jasmehar/Smart_motorcycle_helmet/KiCAD files (PCB design)/Round 2/Motorcycle_Round3_PreMUX/Motorcycle/Motorcycle/Motorcycle/smart_helmet/smart_helmet.kicad_pcb

## KiCad design KiCAD files (PCB design)/Round 2/Motorcycle_Round3_PreMUX/Motorcycle/Motorcycle/Motorcycle/smart_helmet/smart_helmet.kicad_pcb (2024-03-28)

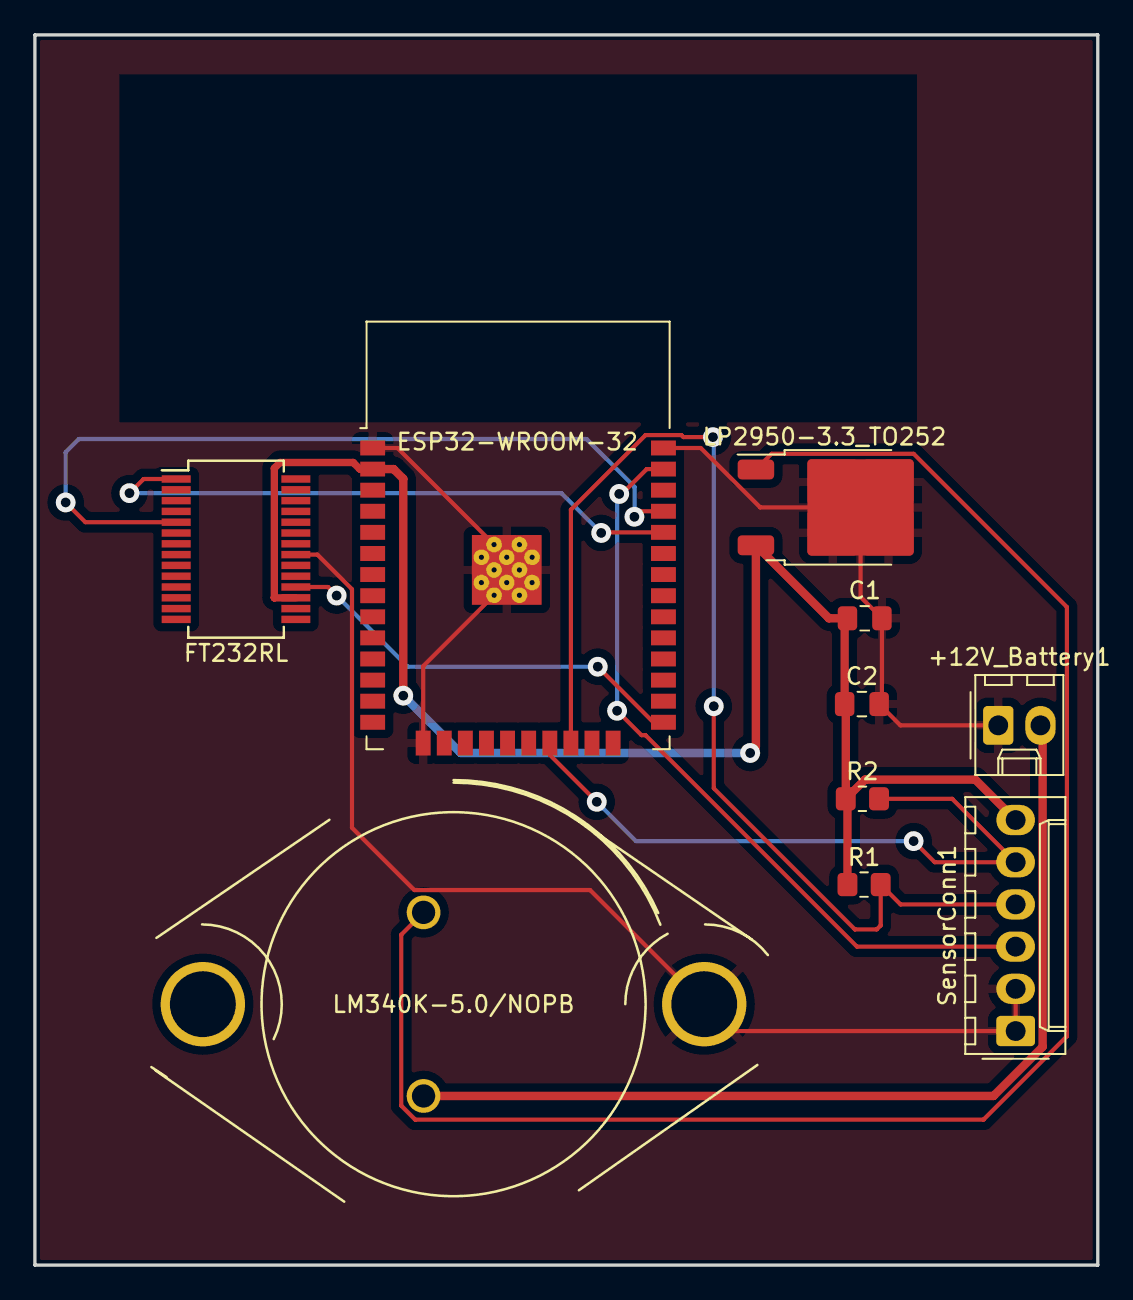
[picture p35: board KiCAD files (PCB design)/Round 2/Motorcycle_Round3_PreMUX/Motorcycle/… from above]

Board: 2 copper layers, 64.0 x 74.0 mm, 10 parts (0 on the bottom side), 10 nets.

Parts:
+12V_Battery1: Conn_01x02; Molex_KK-254_AE-6410-02A_1x02_P2.54mm_Vertical
C1, C2: 0.0000001; C_0805_2012Metric_Pad1.18x1.45mm_HandSolder
R1, R2: 10000; R_0805_2012Metric_Pad1.20x1.40mm_HandSolder
SensorConn1: Conn_01x06; Molex_KK-254_AE-6410-06A_1x06_P2.54mm_Vertical
U1: FT232RL; SSOP-28_5.3x10.2mm_P0.65mm
U3: LM340K-5.0/NOPB; LM340K-5.0&slash_NOPB
U4: LP2950-3.3_TO252; TO-252-2
U5: ESP32-WROOM-32

Connections:
/INT: SensorConn1.3, U5.37 (IO23)
/SCL: R1.2, SensorConn1.4, U5.22 (SDI/SD1)
/SDA: R2.2, SensorConn1.5, U5.21 (SDO/SD0)
/VDD: C1.1, C2.1, R1.1, R2.1, SensorConn1.6, U1.17 (3V3OUT), U4.3 (VO), U5.2 (VDD)
GND: +12V_Battery1.1, C1.2, C2.2, SensorConn1.1, SensorConn1.2, U1.21 (GND), U3.3 (GND), U4.2 (GND), U5.1 (GND), U5.15 (GND), U5.38 (GND), U5.39 (GND)
unnamed: +12V_Battery1.2, U3.1 (IN)
unnamed: U1.5 (RXD), U5.35 (TXD0/IO1)
unnamed: U1.1 (TXD), U5.34 (RXD0/IO3)
unnamed: U3.2 (OUT), U4.1 (VI)
unnamed: U1.18 (GND), U5.25 (IO0)
