jasmehar/Smart_motorcycle_helmet/KiCAD files (PCB design)/Round 2/Helmet_Round3_PreMUX/Helmet/Helmet/Helmet/shematic for power and light system.kicad_pcb

## KiCad design KiCAD files (PCB design)/Round 2/Helmet_Round3_PreMUX/Helmet/Helmet/Helmet/shematic for power and light system.kicad_pcb (2024-03-28)

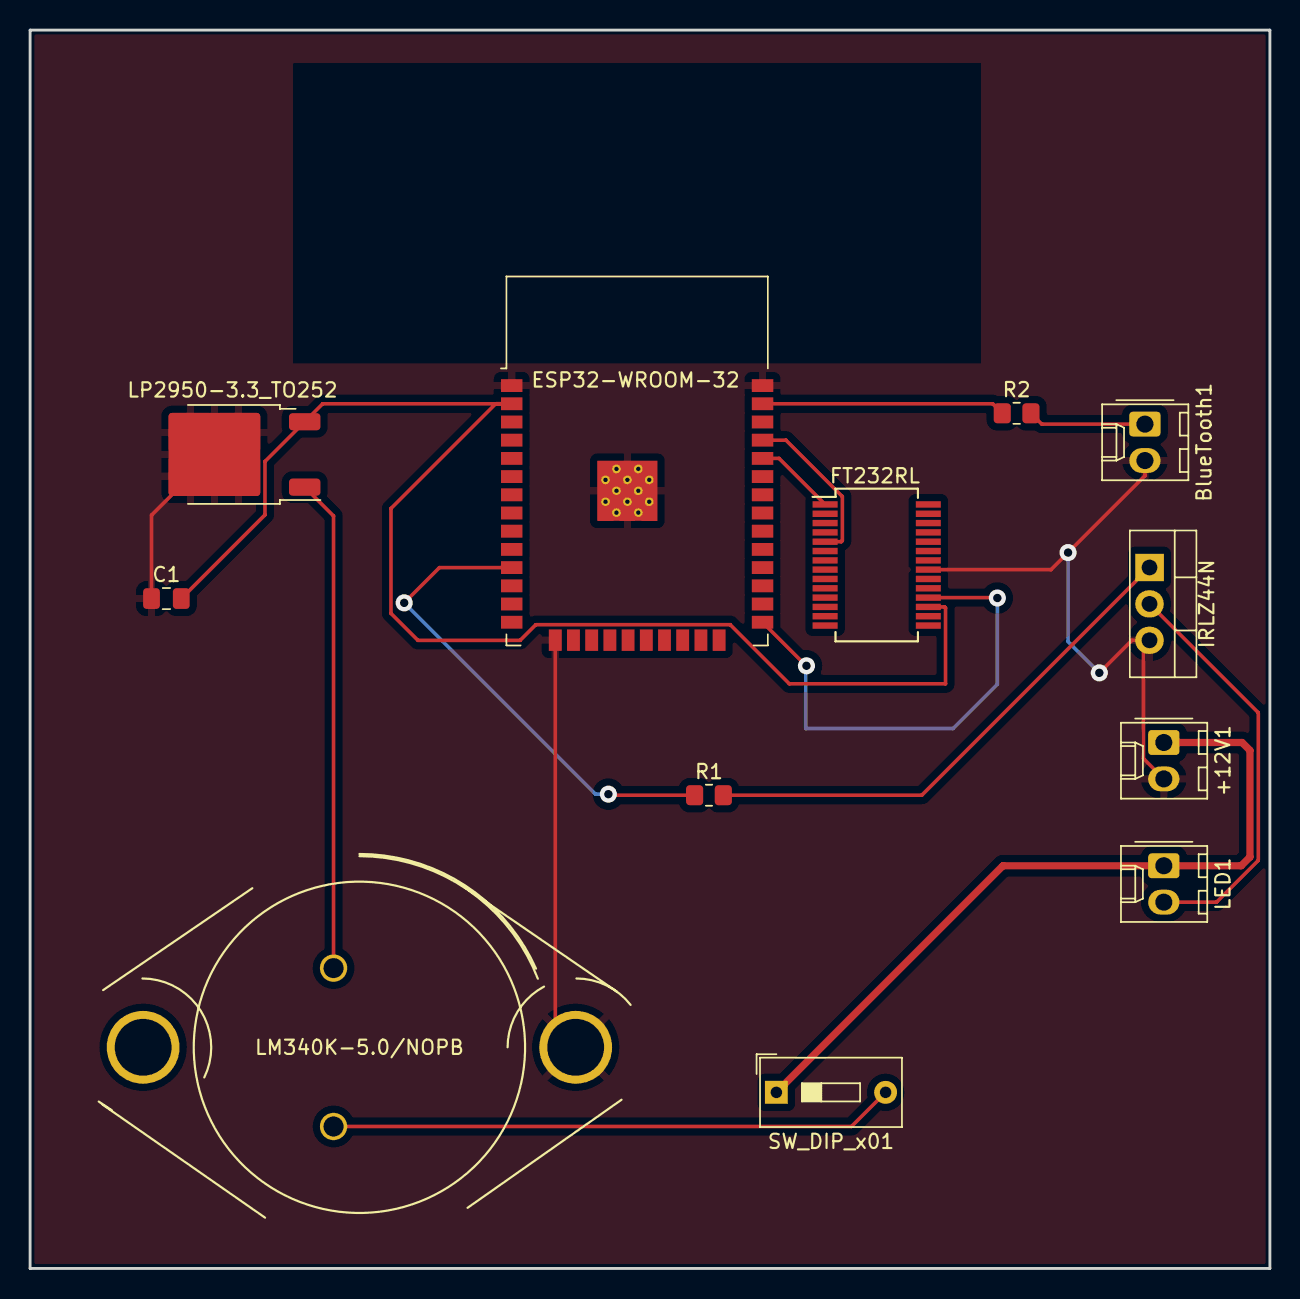
[picture p36: board KiCAD files (PCB design)/Round 2/Helmet_Round3_PreMUX/Helmet/Helmet/H… from above]

Board: 2 copper layers, 86.5 x 86.4 mm, 12 parts (0 on the bottom side), 13 nets.

Parts:
+12V1: Conn_01x02; Molex_KK-254_AE-6410-02A_1x02_P2.54mm_Vertical
BlueTooth1: LED; Molex_KK-254_AE-6410-02A_1x02_P2.54mm_Vertical
C1: 0.0000001; C_0805_2012Metric_Pad1.18x1.45mm_HandSolder
LED1: Conn_01x02; Molex_KK-254_AE-6410-02A_1x02_P2.54mm_Vertical
Q1: IRLZ44N; TO-220-3_Vertical
R1, R2: 10000; R_0805_2012Metric_Pad1.20x1.40mm_HandSolder
SW1: SW_DIP_x01; SW_DIP_SPSTx01_Slide_9.78x4.72mm_W7.62mm_P2.54mm
U1: LM340K-5.0/NOPB; LM340K-5.0&slash_NOPB
U2: LP2950-3.3_TO252; TO-252-2
U3: ESP32-WROOM-32
U4: FT232RL; SSOP-28_5.3x10.2mm_P0.65mm

Connections:
GND: +12V1.2, BlueTooth1.2, C1.1, Q1.3 (S), U1.3 (GND), U2.2 (GND), U3.1 (GND), U3.15 (GND), U3.38 (GND), U3.39 (GND), U4.21 (GND)
unnamed: +12V1.1, LED1.1, SW1.1
unnamed: BlueTooth1.1, R2.2
unnamed: LED1.2, Q1.2 (D)
unnamed: Q1.1 (G), R1.2
unnamed: SW1.2, U1.1 (IN)
unnamed: U1.2 (OUT), U2.1 (VI)
unnamed: C1.2, U2.3 (VO), U3.2 (VDD), U4.17 (3V3OUT)
unnamed: U3.25 (IO0), U4.18 (GND)
unnamed: R2.1, U3.37 (IO23)
unnamed: R1.1, U3.11 (IO26)
unnamed: U3.34 (RXD0/IO3), U4.1 (TXD)
unnamed: U3.35 (TXD0/IO1), U4.5 (RXD)
