jasmehar/Smart_motorcycle_helmet/KiCAD files (PCB design)/Round 1/Motorcycle/smart_helmet/smart_helmet.kicad_pcb

## KiCad design KiCAD files (PCB design)/Round 1/Motorcycle/smart_helmet/smart_helmet.kicad_pcb (2024-03-01)

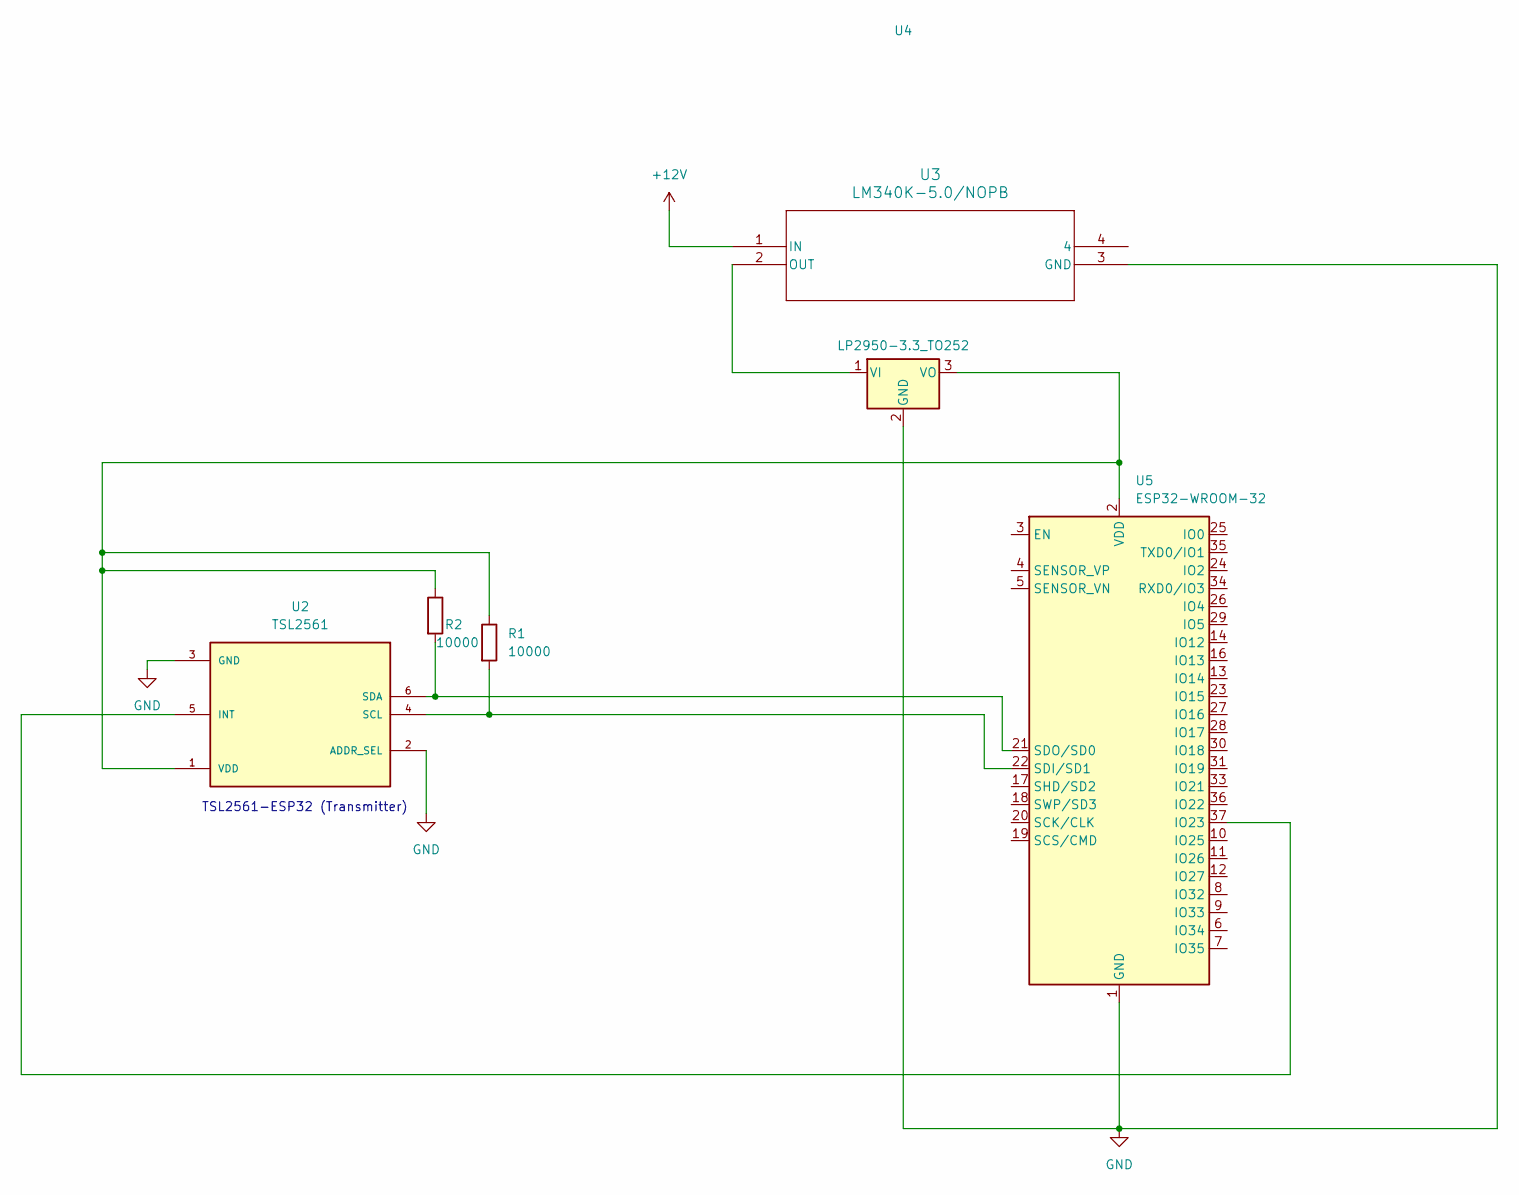
[picture p37: schematic smart_helmet.kicad_sch]

Parts:
R1, R2: 10000; R_0805_2012Metric_Pad1.20x1.40mm_HandSolder
U2: TSL2561; XDCR_TSL2561; PARTREV v1-01
U3: LM340K-5.0/NOPB; LM340K-5.0&slash_NOPB
U4: LP2950-3.3_TO252; TO-252-2
U5: ESP32-WROOM-32

Connections:
+12V: U3.1 (IN)
GND: U2.2 (ADDR_SEL), U2.3 (GND), U3.3 (GND), U4.2 (GND), U5.1 (GND), U5.15 (GND), U5.38 (GND), U5.39 (GND)
unnamed: U2.5 (INT), U5.37 (IO23)
unnamed: R1.2, U2.4 (SCL), U5.22 (SDI/SD1)
unnamed: R2.2, U2.6 (SDA), U5.21 (SDO/SD0)
unnamed: R1.1, R2.1, U2.1 (VDD), U4.3 (VO), U5.2 (VDD)
unnamed: U3.2 (OUT), U4.1 (VI)

Notes on the sheet:
TSL2561-ESP32 (Transmitter)

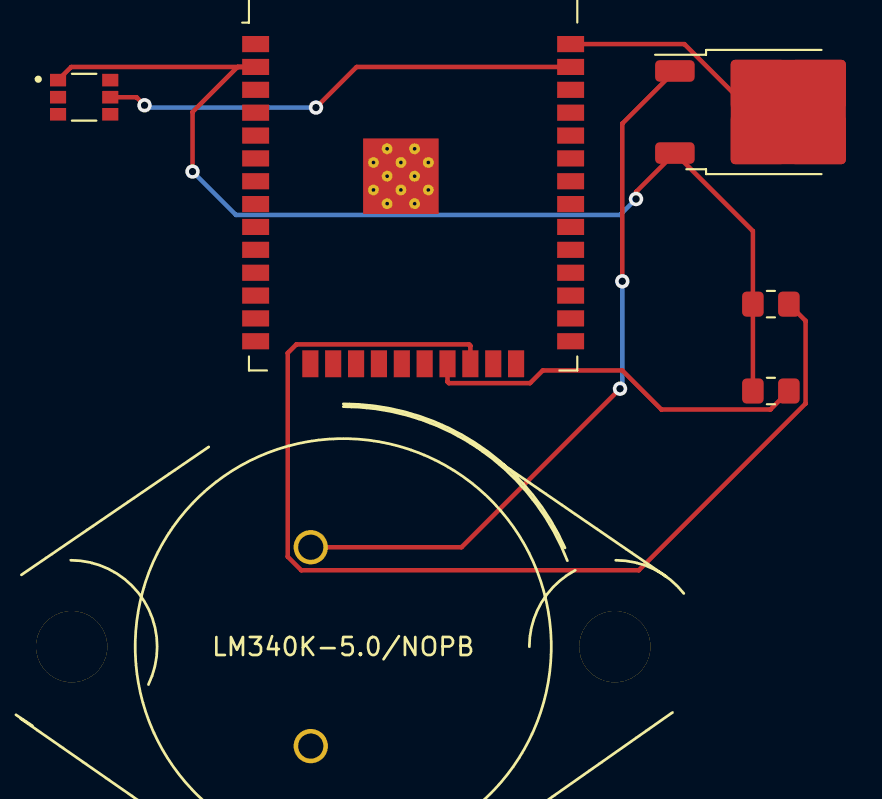
[picture p38: board KiCAD files (PCB design)/Round 1/Motorcycle/smart_helmet/smart_helmet… from above]

Board: 2 copper layers, 6 parts (0 on the bottom side), 6 nets.
