jasmehar/Smart_motorcycle_helmet/KiCAD files (PCB design)/Round 3/Motorcycle_Round3/Motorcycle/Motorcycle/Motorcycle/smart_helmet/smart_helmet.kicad_pcb

## KiCad design KiCAD files (PCB design)/Round 3/Motorcycle_Round3/Motorcycle/Motorcycle/Motorcycle/smart_helmet/smart_helmet.kicad_pcb (2024-03-28)

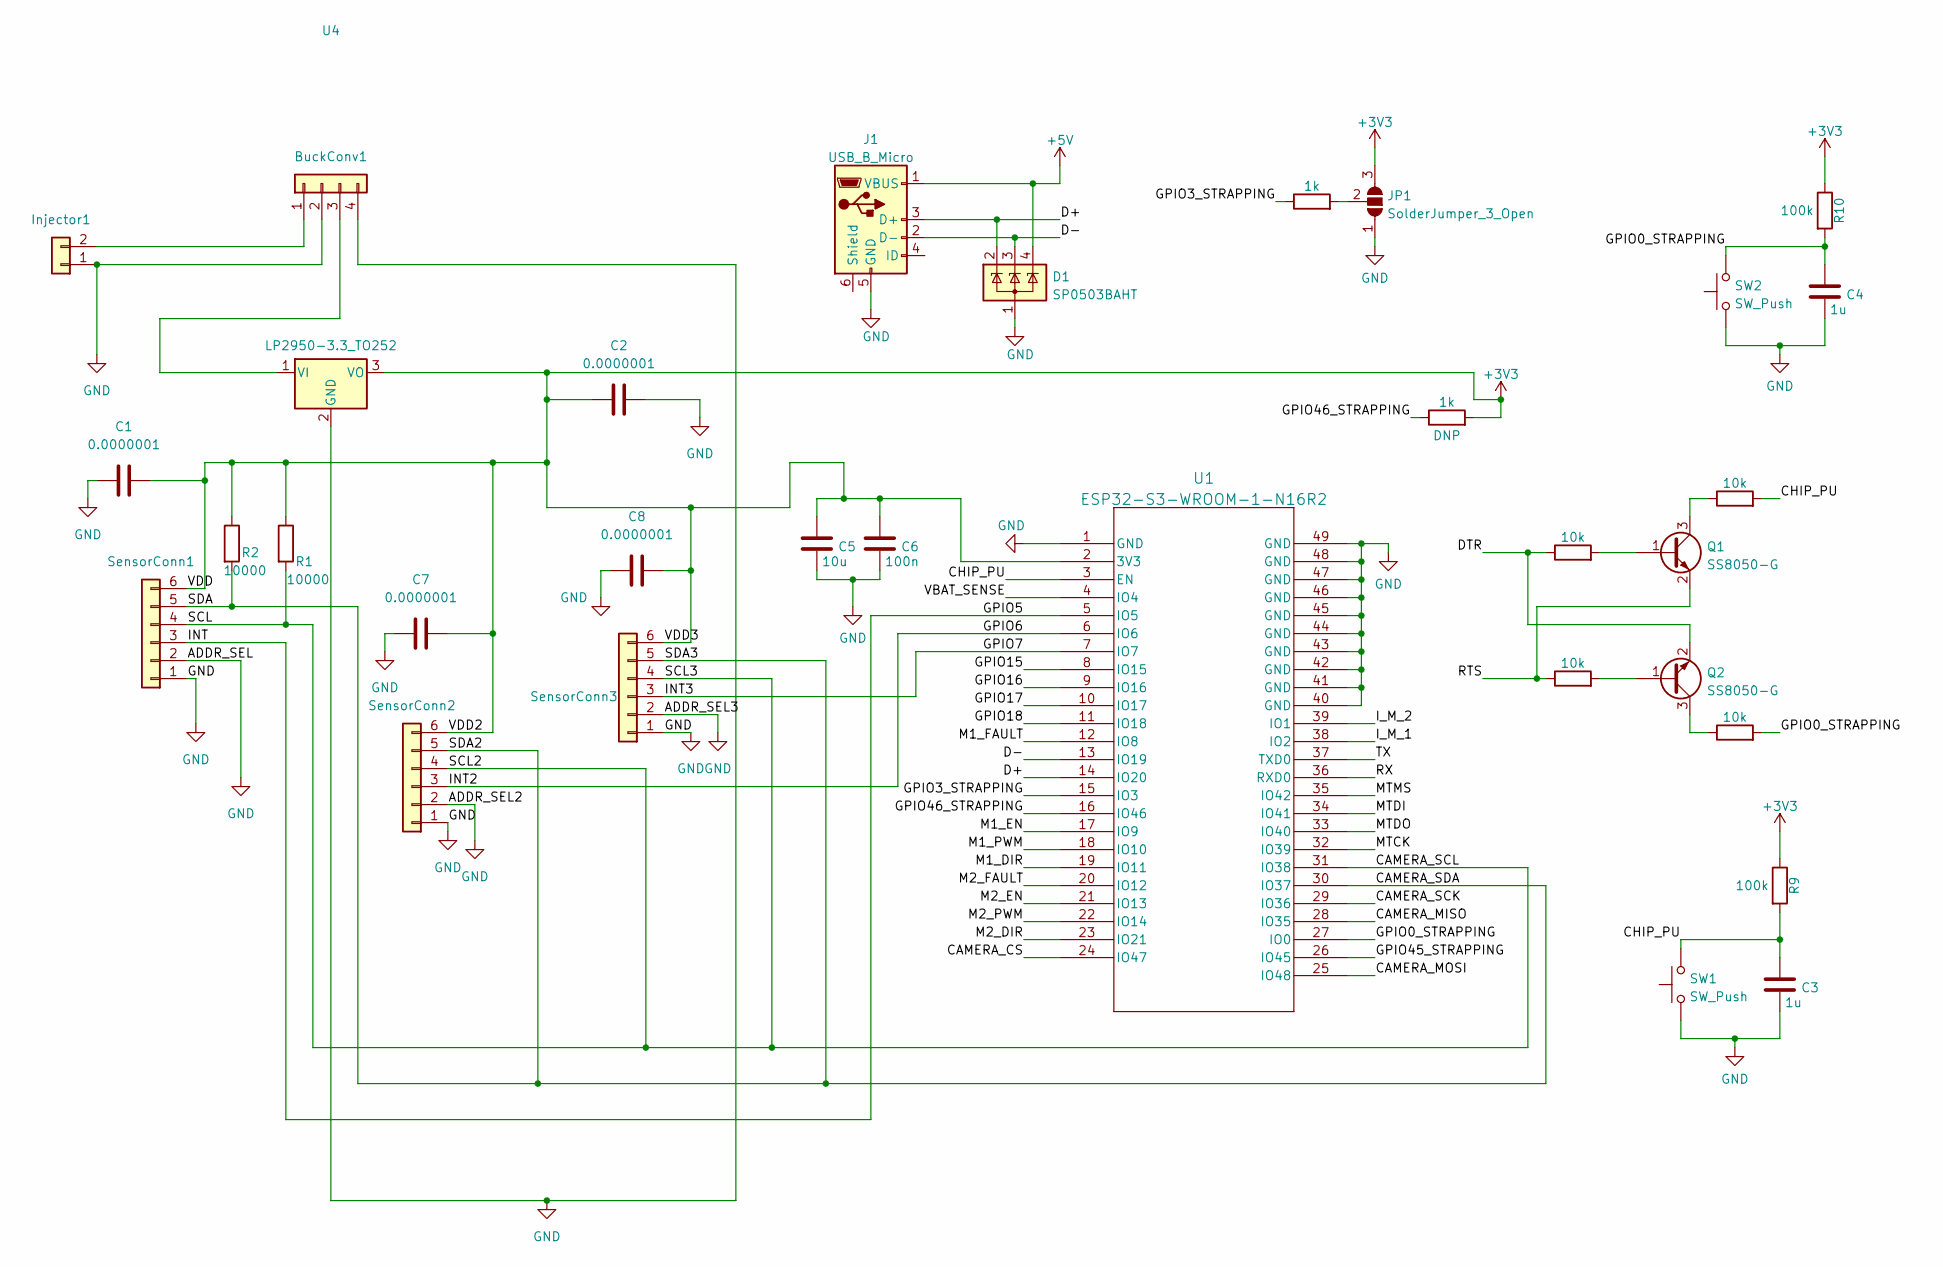
[picture p39: schematic smart_helmet.kicad_sch]

Parts:
BuckConv1: Conn_01x04; Molex_KK-254_AE-6410-04A_1x04_P2.54mm_Vertical
C1, C2, C7, C8: 0.0000001; C_0805_2012Metric_Pad1.18x1.45mm_HandSolder
C3, C4: 1u; C_0805_2012Metric
C5: 10u; C_0805_2012Metric
C6: 100n; C_0805_2012Metric
D1: SP0503BAHT; SOT-143
Injector1: Conn_01x02; Molex_KK-254_AE-6410-02A_1x02_P2.54mm_Vertical
J1: USB_B_Micro; USB_Micro-B_Amphenol_10118194_Horizontal
JP1: SolderJumper_3_Open; SolderJumper-3_P2.0mm_Open_TrianglePad1.0x1.5mm
Q1, Q2: SS8050-G; SOT-23
R1, R2: 10000; R_0805_2012Metric_Pad1.20x1.40mm_HandSolder
R3, R6: 1k; R_0805_2012Metric
R4, R5, R7, R8: 10k; R_0805_2012Metric
R9, R10: 100k; R_0805_2012Metric
SW1, SW2: SW_Push; SW_SPST_B3S-1000
SensorConn1, SensorConn2, SensorConn3: Conn_01x06; Molex_KK-254_AE-6410-06A_1x06_P2.54mm_Vertical
U1: ESP32-S3-WROOM-1-N16R2; ESP32-S3-WROOM-1_EXP
U4: LP2950-3.3_TO252; LP3_TEX

Connections:
+3V3: C1.1, C2.1, C5.1, C6.1, C7.1, C8.1, JP1.3 (B), R1.1, R2.1, R3.2, R9.1, R10.1, SensorConn1.6, SensorConn2.6, SensorConn3.6, U1.2 (3V3), U4.3 (VO)
+5V: D1.4 (K), J1.1 (VBUS)
/CAMERA_CS: U1.24 (IO47)
/CAMERA_MISO: U1.28 (IO35)
/CAMERA_MOSI: U1.25 (IO48)
/CAMERA_SCK: U1.29 (IO36)
/CAMERA_SCL: R1.2, SensorConn1.4, SensorConn2.4, SensorConn3.4, U1.31 (IO38)
/CAMERA_SDA: R2.2, SensorConn1.5, SensorConn2.5, SensorConn3.5, U1.30 (IO37)
/CHIP_PU: C3.1, R7.2, R9.2, SW1.2, U1.3 (EN)
/D+: D1.2 (K), J1.3 (D+), U1.14 (IO20)
/D-: D1.3 (K), J1.2 (D-), U1.13 (IO19)
/DTR: Q2.2 (E), R4.1
/GPIO0_STRAPPING: C4.1, R8.2, R10.2, SW2.2, U1.27 (IO0)
/GPIO3_STRAPPING: R6.1, U1.15 (IO3)
/GPIO5: SensorConn1.3, U1.5 (IO5)
/GPIO6: SensorConn2.3, U1.6 (IO6)
/GPIO7: SensorConn3.3, U1.7 (IO7)
/GPIO15: U1.8 (IO15)
/GPIO16: U1.9 (IO16)
/GPIO17: U1.10 (IO17)
/GPIO18: U1.11 (IO18)
/GPIO45_STRAPPING: U1.26 (IO45)
/GPIO46_STRAPPING: R3.1, U1.16 (IO46)
/I_M_1: U1.38 (IO2)
/I_M_2: U1.39 (IO1)
/M1_DIR: U1.19 (IO11)
/M1_EN: U1.17 (IO9)
/M1_FAULT: U1.12 (IO8)
/M1_PWM: U1.18 (IO10)
/M2_DIR: U1.23 (IO21)
/M2_EN: U1.21 (IO13)
/M2_FAULT: U1.20 (IO12)
/M2_PWM: U1.22 (IO14)
/MTCK: U1.32 (IO39)
/MTDI: U1.34 (IO41)
/MTDO: U1.33 (IO40)
/MTMS: U1.35 (IO42)
/RTS: Q1.2 (E), R5.1
/RX: U1.36 (RXD0)
/TX: U1.37 (TXD0)
/VBAT_SENSE: U1.4 (IO4)
GND: BuckConv1.2, BuckConv1.4, C1.2, C2.2, C3.2, C4.2, C5.2, C6.2, C7.2, C8.2, D1.1 (A), Injector1.1, J1.5 (GND), JP1.1 (A), SW1.1, SW2.1, SensorConn1.1, SensorConn1.2, SensorConn2.1, SensorConn2.2, SensorConn3.1, SensorConn3.2, U1.1 (GND), U1.40 (GND), U1.41 (GND), U1.42 (GND), U1.43 (GND), U1.44 (GND), U1.45 (GND), U1.46 (GND), U1.47 (GND), U1.48 (GND), U1.49 (GND), U4.2 (GND)
unnamed: BuckConv1.1, Injector1.2
unnamed: BuckConv1.3, U4.1 (VI)
unnamed: JP1.2 (C), R6.2
unnamed: Q1.1 (B), R4.2
unnamed: Q1.3 (C), R7.1
unnamed: Q2.1 (B), R5.2
unnamed: Q2.3 (C), R8.1

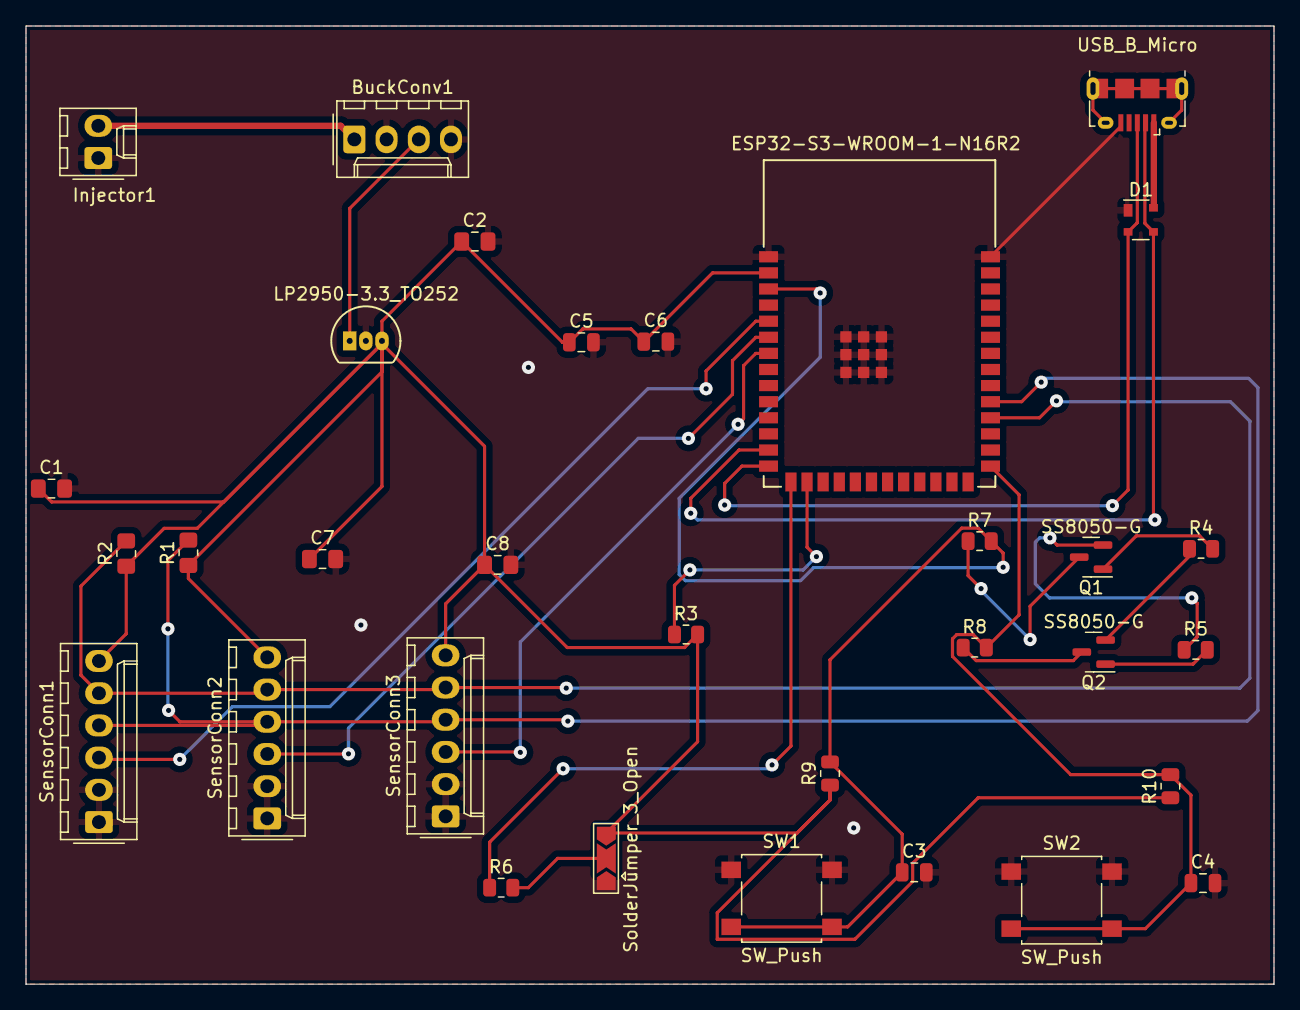
[picture p40: board KiCAD files (PCB design)/Round 3/Motorcycle_Round3/Motorcycle/Motorcy… from above]

Board: 2 copper layers, 98.4 x 75.6 mm, 32 parts (0 on the bottom side), 23 nets.
