jasmehar/Smart_motorcycle_helmet/KiCAD files (PCB design)/Round 3/Helmet_Round3/Helmet/Helmet/shematic for power and light system.kicad_pcb

## KiCad design KiCAD files (PCB design)/Round 3/Helmet_Round3/Helmet/Helmet/shematic for power and light system.kicad_pcb (2024-03-28)

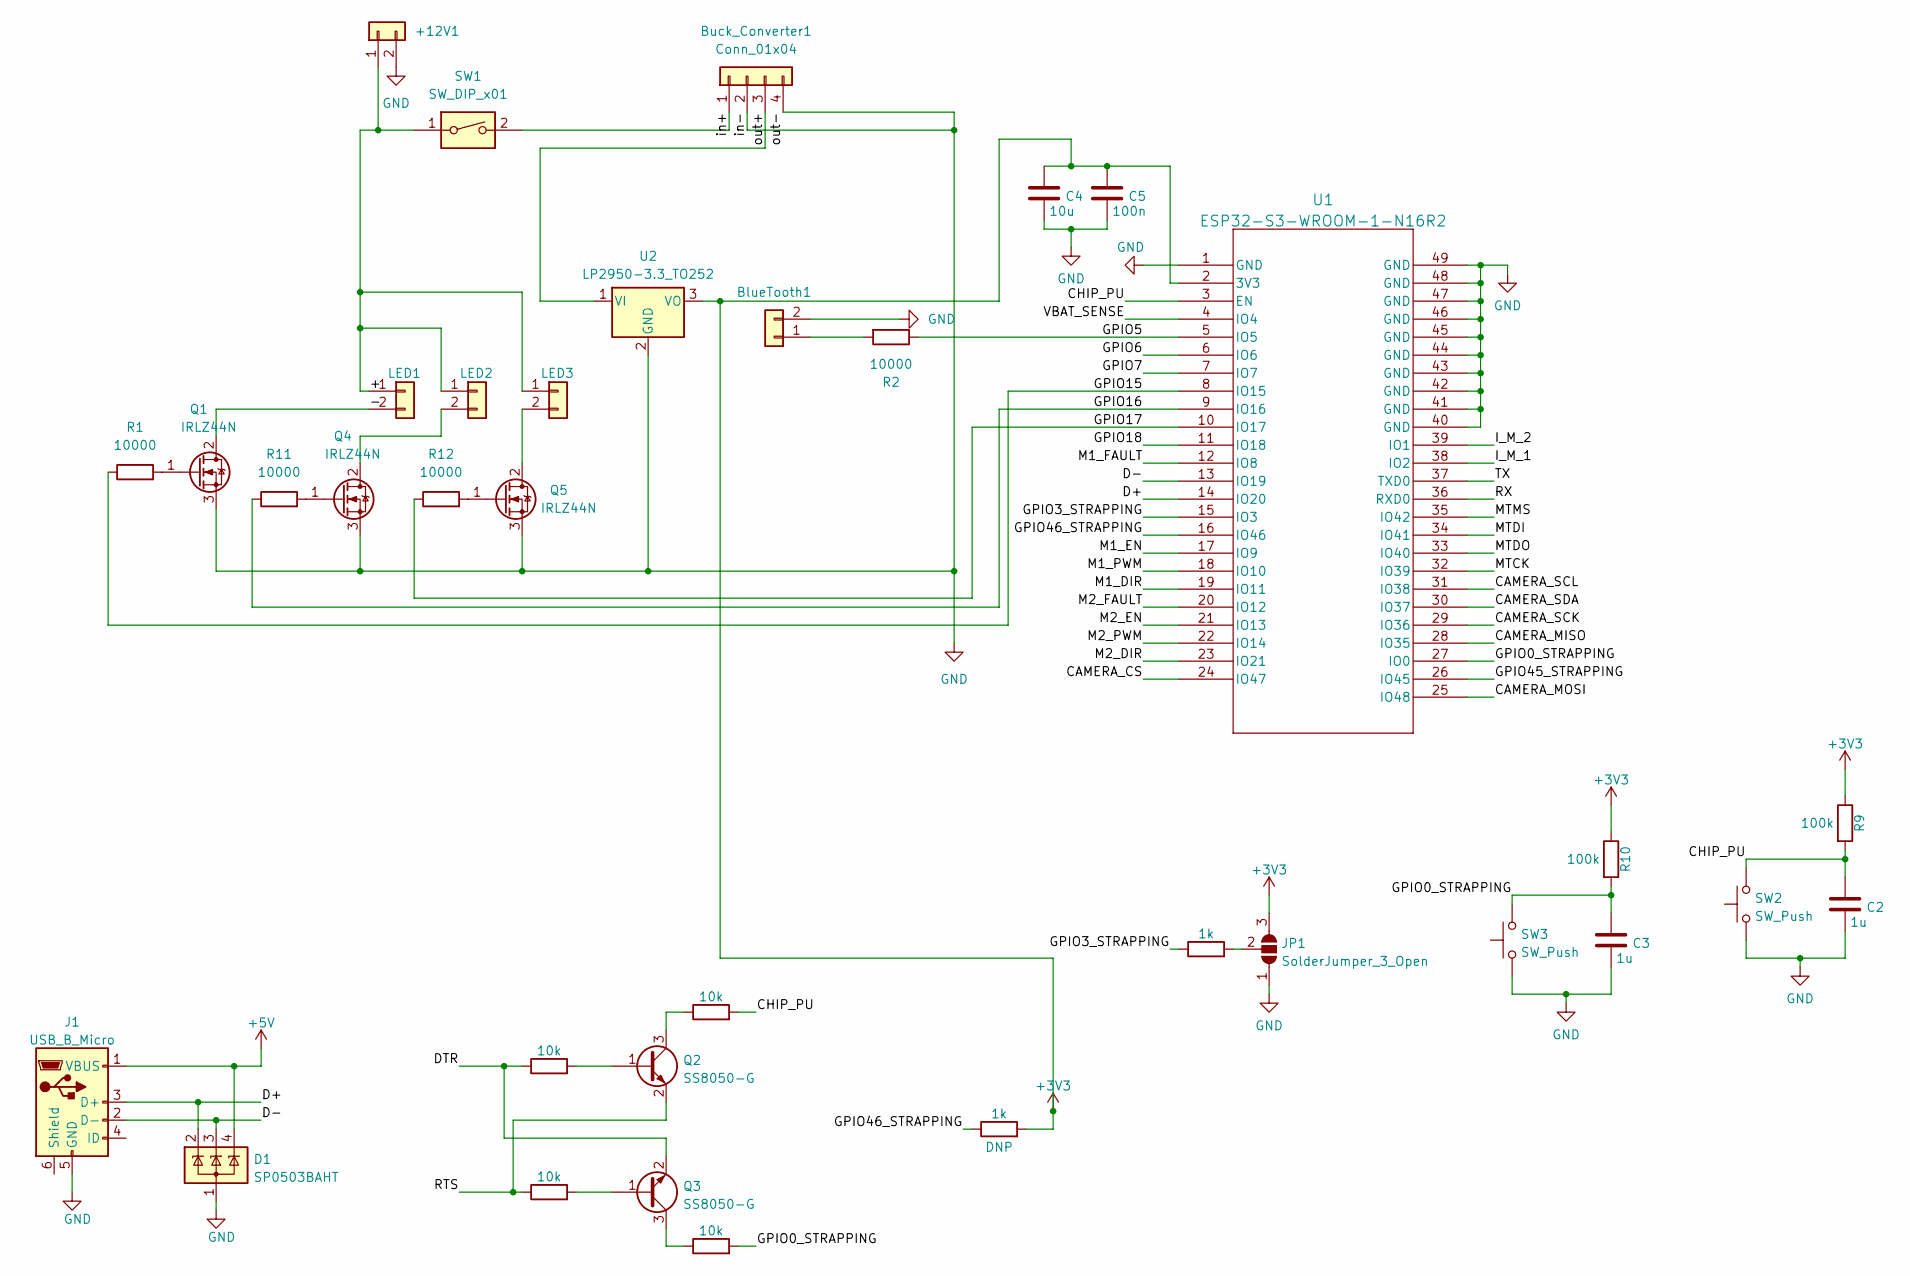
[picture p41: schematic shematic for power and light system.kicad_sch]

Parts:
+12V1: Conn_01x02; Molex_KK-254_AE-6410-02A_1x02_P2.54mm_Vertical
BlueTooth1: LED; Molex_KK-254_AE-6410-02A_1x02_P2.54mm_Vertical
Buck_Converter1: Conn_01x04; Molex_KK-254_AE-6410-04A_1x04_P2.54mm_Vertical
C2, C3: 1u; C_0805_2012Metric
C4: 10u; C_0805_2012Metric
C5: 100n; C_0805_2012Metric
D1: SP0503BAHT; SOT-143
J1: USB_B_Micro; USB_Micro-B_Amphenol_10118194_Horizontal
JP1: SolderJumper_3_Open; SolderJumper-3_P2.0mm_Open_TrianglePad1.0x1.5mm
LED1, LED2, LED3: Conn_01x02; Molex_KK-254_AE-6410-02A_1x02_P2.54mm_Vertical
Q1, Q4, Q5: IRLZ44N; PG-TO220-3_INF
Q2, Q3: SS8050-G; SOT-23
R1, R2, R11, R12: 10000; R_0805_2012Metric_Pad1.20x1.40mm_HandSolder
R3, R6: 1k; R_0805_2012Metric
R4, R5, R7, R8: 10k; R_0805_2012Metric
R9, R10: 100k; R_0805_2012Metric
SW1: SW_DIP_x01; SW_DIP_SPSTx01_Slide_9.78x4.72mm_W7.62mm_P2.54mm
SW2, SW3: SW_Push; SW_SPST_B3S-1000
U1: ESP32-S3-WROOM-1-N16R2; ESP32-S3-WROOM-1_EXP
U2: LP2950-3.3_TO252; LP3_TEX

Connections:
+3V3: C4.1, C5.1, JP1.3 (B), R3.2, R9.1, R10.1, U1.2 (3V3), U2.3 (VO)
+5V: D1.4 (K), J1.1 (VBUS)
/+: +12V1.1, LED1.1, LED2.1, LED3.1, SW1.1
/-: LED1.2, Q1.2 (D)
/CAMERA_CS: U1.24 (IO47)
/CAMERA_MISO: U1.28 (IO35)
/CAMERA_MOSI: U1.25 (IO48)
/CAMERA_SCK: U1.29 (IO36)
/CAMERA_SCL: U1.31 (IO38)
/CAMERA_SDA: U1.30 (IO37)
/CHIP_PU: C2.1, R7.2, R9.2, SW2.2, U1.3 (EN)
/D+: D1.2 (K), J1.3 (D+), U1.14 (IO20)
/D-: D1.3 (K), J1.2 (D-), U1.13 (IO19)
/DTR: Q3.2 (E), R4.1
/GPIO0_STRAPPING: C3.1, R8.2, R10.2, SW3.2, U1.27 (IO0)
/GPIO3_STRAPPING: R6.1, U1.15 (IO3)
/GPIO5: R2.1, U1.5 (IO5)
/GPIO6: U1.6 (IO6)
/GPIO7: U1.7 (IO7)
/GPIO15: R1.1, U1.8 (IO15)
/GPIO16: R11.1, U1.9 (IO16)
/GPIO17: R12.1, U1.10 (IO17)
/GPIO18: U1.11 (IO18)
/GPIO45_STRAPPING: U1.26 (IO45)
/GPIO46_STRAPPING: R3.1, U1.16 (IO46)
/I_M_1: U1.38 (IO2)
/I_M_2: U1.39 (IO1)
/M1_DIR: U1.19 (IO11)
/M1_EN: U1.17 (IO9)
/M1_FAULT: U1.12 (IO8)
/M1_PWM: U1.18 (IO10)
/M2_DIR: U1.23 (IO21)
/M2_EN: U1.21 (IO13)
/M2_FAULT: U1.20 (IO12)
/M2_PWM: U1.22 (IO14)
/MTCK: U1.32 (IO39)
/MTDI: U1.34 (IO41)
/MTDO: U1.33 (IO40)
/MTMS: U1.35 (IO42)
/RTS: Q2.2 (E), R5.1
/RX: U1.36 (RXD0)
/TX: U1.37 (TXD0)
/VBAT_SENSE: U1.4 (IO4)
/in+: Buck_Converter1.1, SW1.2
/out+: Buck_Converter1.3, U2.1 (VI)
GND: +12V1.2, BlueTooth1.2, Buck_Converter1.2, Buck_Converter1.4, C2.2, C3.2, C4.2, C5.2, D1.1 (A), J1.5 (GND), JP1.1 (A), Q1.3 (S), Q4.3 (S), Q5.3 (S), SW2.1, SW3.1, U1.1 (GND), U1.40 (GND), U1.41 (GND), U1.42 (GND), U1.43 (GND), U1.44 (GND), U1.45 (GND), U1.46 (GND), U1.47 (GND), U1.48 (GND), U1.49 (GND), U2.2 (GND)
unnamed: BlueTooth1.1, R2.2
unnamed: JP1.2 (C), R6.2
unnamed: LED2.2, Q4.2 (D)
unnamed: LED3.2, Q5.2 (D)
unnamed: Q1.1 (G), R1.2
unnamed: Q2.1 (B), R4.2
unnamed: Q2.3 (C), R7.1
unnamed: Q3.1 (B), R5.2
unnamed: Q3.3 (C), R8.1
unnamed: Q4.1 (G), R11.2
unnamed: Q5.1 (G), R12.2

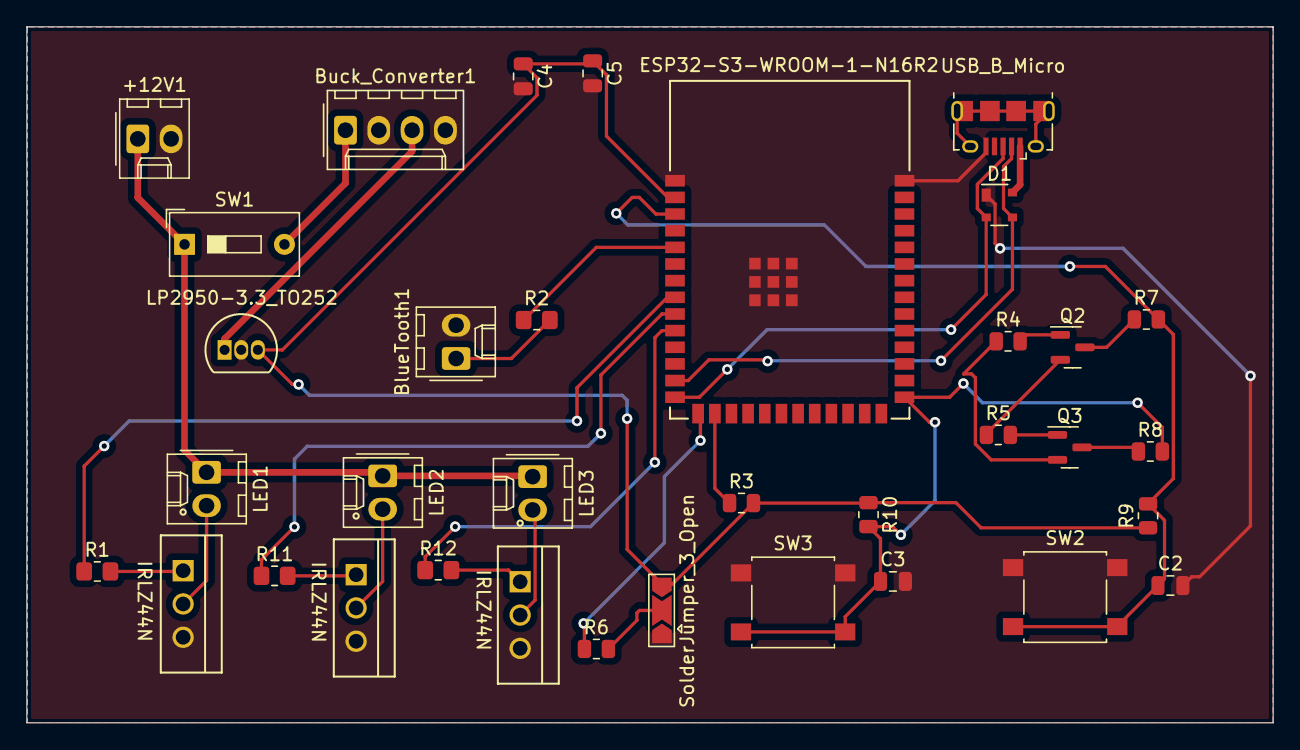
[picture p42: board KiCAD files (PCB design)/Round 3/Helmet_Round3/Helmet/Helmet/shematic… from above]

Board: 2 copper layers, 95.0 x 53.1 mm, 35 parts (0 on the bottom side), 30 nets.
