jasmehar/Smart_motorcycle_helmet/(commit log)

2024-02-29 adding inital design schematics
    [shematic for power and light system.kicad_pcb, shematic for power and light system.kicad_sch, smart_helmet.kicad_pcb, smart_helmet.kicad_sch]
2024-02-29 adding inital pcb schematics
    [shematic for power and light system.kicad_pcb, shematic for power and light system.kicad_sch, smart_helmet.kicad_pcb, smart_helmet.kicad_sch]
2024-03-01 first draft PCB done
    [shematic for power and light system.kicad_pcb, shematic for power and light system.kicad_sch, smart_helmet.kicad_pcb, smart_helmet.kicad_sch]
2024-03-28 finished 3rd round of PCB added buck converter connector
    [shematic for power and light system-B_Cu.gbr, shematic for power and light system-B_Mask.gbr, shematic for power and light system-B_Paste.gbr, shematic for power and light system-B_Silkscreen.gbr, shematic for power and light system-Edge_Cuts.gbr, shematic for power and light system-F_Cu.gbr, shematic for power and light system-F_Mask.gbr, shematic for power and light system-F_Paste.gbr]
2024-03-30 motorcycle ESP programming done
2024-04-01 deciding to use Arduino instead cuz no way in hell am I using ESP-IDF until I get more time
    [shematic for power and light system-B_Cu.gbr, shematic for power and light system-B_Mask.gbr, shematic for power and light system-B_Paste.gbr, shematic for power and light system-B_Silkscreen.gbr, shematic for power and light system-Edge_Cuts.gbr, shematic for power and light system-F_Cu.gbr, shematic for power and light system-F_Mask.gbr, shematic for power and light system-F_Paste.gbr]
2024-04-02 all of motorcycle code is done
2024-04-11 all code done
    [shematic for power and light system-B_Cu.gbr, shematic for power and light system-B_Mask.gbr, shematic for power and light system-B_Paste.gbr, shematic for power and light system-B_Silkscreen.gbr, shematic for power and light system-Edge_Cuts.gbr, shematic for power and light system-F_Cu.gbr, shematic for power and light system-F_Mask.gbr, shematic for power and light system-F_Paste.gbr]
